kgiorgi/synthy/BOM.csv

Item | Qty | Supplier | Cost/item | Total Cost | link
LMC555CN timer (DIP-8) | 2 | LCSC | $1.69 | $3.38 | https://www.lcsc.com/product-detail/C1520185.html
CD74HC4017E counter (DIP-16) | 1 | LCSC | $0.86 | $0.86 | https://www.lcsc.com/product-detail/C354048.html
LM386N-1 amplifier (DIP-8) | 1 | LCSC | $0.90 | $0.90 | https://www.lcsc.com/product-detail/C9723.html
Slide switch SPDT (C&K OS102011MS2QN1) | 2 | LCSC | $0.66 | $1.32 | https://www.lcsc.com/product-detail/C221829.html
USB-C power socket (GCT USB4125-GF-A) | 1 | LCSC | $0.60 | $0.60 | https://www.lcsc.com/product-detail/C3151650.html
JST PH 2-pin header (min order 20) | 20 | LCSC | $0.04 | $0.80 | https://www.lcsc.com/product-detail/C131337.html
PCB 2-layer 100x100mm (5 boards) | 1 | JLCPCB | $2.00 | $2.00 | https://jlcpcb.com/quote
Resistor kit 1/4W metal film (30 values) | 1 | AliExpress | $2.00 | $2.00 | https://www.aliexpress.com/w/wholesale-metal-film-resistor-kit-1%2F4w.html
Ceramic capacitor kit (2pF to 100nF) | 1 | AliExpress | $2.00 | $2.00 | https://www.aliexpress.com/w/wholesale-ceramic-capacitor-kit.html
1uF ceramic capacitor 5mm pitch (10 pcs) | 1 | AliExpress | $0.50 | $0.50 | https://www.aliexpress.com/w/wholesale-1uf-ceramic-capacitor-105.html
47nF film capacitor CBB/MKT 473 (10 pcs) | 1 | AliExpress | $0.80 | $0.80 | https://www.aliexpress.com/w/wholesale-473-film-capacitor.html
10uF 25V electrolytic 5mm (10 pcs) | 1 | AliExpress | $0.50 | $0.50 | https://www.aliexpress.com/w/wholesale-10uf-25v-electrolytic-capacitor.html
100uF 16V electrolytic 6.3mm (10 pcs) | 1 | AliExpress | $0.60 | $0.60 | https://www.aliexpress.com/w/wholesale-100uf-16v-electrolytic-capacitor.html
220uF 16V electrolytic 8mm (10 pcs) | 1 | AliExpress | $0.70 | $0.70 | https://www.aliexpress.com/w/wholesale-220uf-16v-electrolytic-capacitor.html
3mm red LEDs (50 pcs) | 1 | AliExpress | $0.80 | $0.80 | https://www.aliexpress.com/w/wholesale-3mm-red-led.html
1N4148 diodes (100 pcs) | 1 | AliExpress | $0.80 | $0.80 | https://www.aliexpress.com/w/wholesale-1n4148-diode.html
DIP-8 IC sockets (10 pcs) | 1 | AliExpress | $0.60 | $0.60 | https://www.aliexpress.com/w/wholesale-dip8-ic-socket.html
DIP-16 IC sockets (10 pcs) | 1 | AliExpress | $0.70 | $0.70 | https://www.aliexpress.com/w/wholesale-dip16-ic-socket.html
8-way DIP switch 2.54mm (5 pcs) | 1 | AliExpress | $1.00 | $1.00 | https://www.aliexpress.com/w/wholesale-8-way-dip-switch-2.54mm.html
8 ohm 0.5W speaker 40mm (2 pcs) | 1 | AliExpress | $1.50 | $1.50 | https://www.aliexpress.com/w/wholesale-8-ohm-0.5w-speaker-40mm.html
RK097 9mm potentiometers (10x B100K 2x B50K 2x A100K) | 1 | AliExpress | $0.00 | $0.00 | https://www.aliexpress.com/w/wholesale-rk097-potentiometer.html
Estimated total shipping | 1 |  |  | $0.00
