kgiorgi/synthy/hardware/kicad/synthy/synthy.pdf

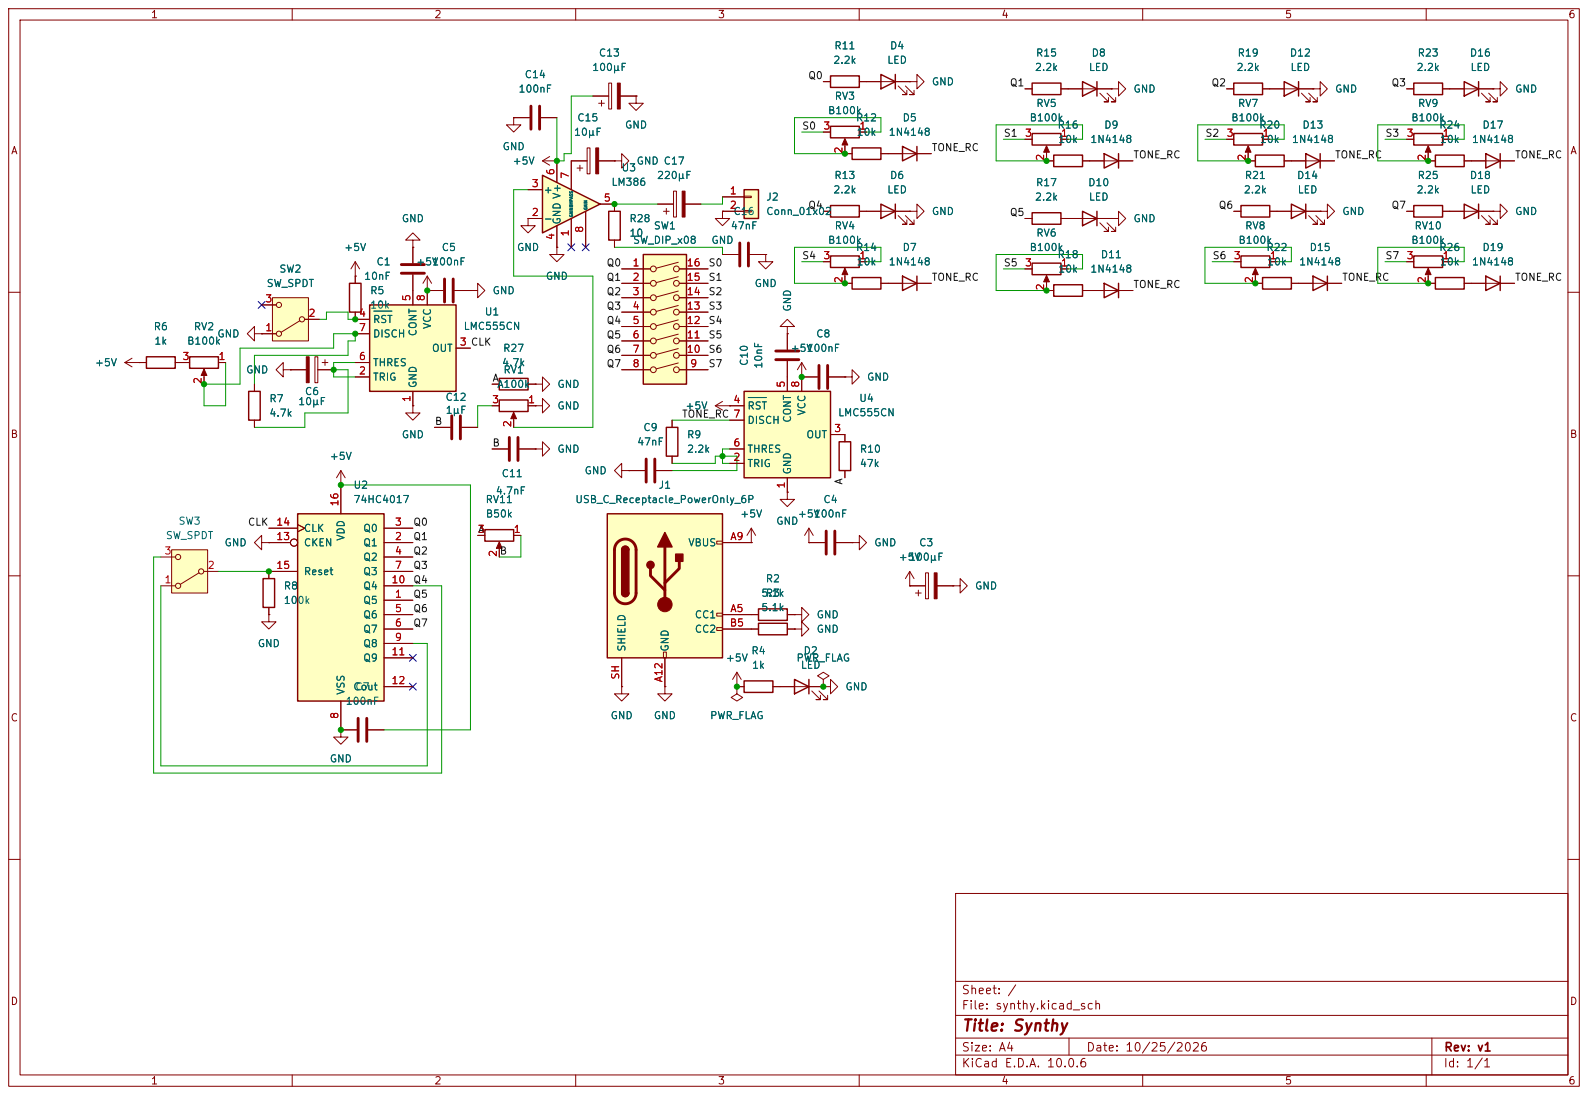
[picture p2: page 1]

8 Q8 9 Q4 10 Q9 11 Cout 12 CKEN 13 CLK 14 Reset 15 VDD 16 U2

8 Q8 9 Q4 10 Q9 11 Cout 12 CKEN 13 CLK 14 Reset 15 VDD 16 GND

Size: A4 | Rev: v1
KiCad E.D.A. 10.0.6 | Id: 1/1
