kgiorgi/synthy/hardware/kicad/synthy/synthy.kicad_pcb

## KiCad design hardware/kicad/synthy/synthy.kicad_pcb (2026-10-25)

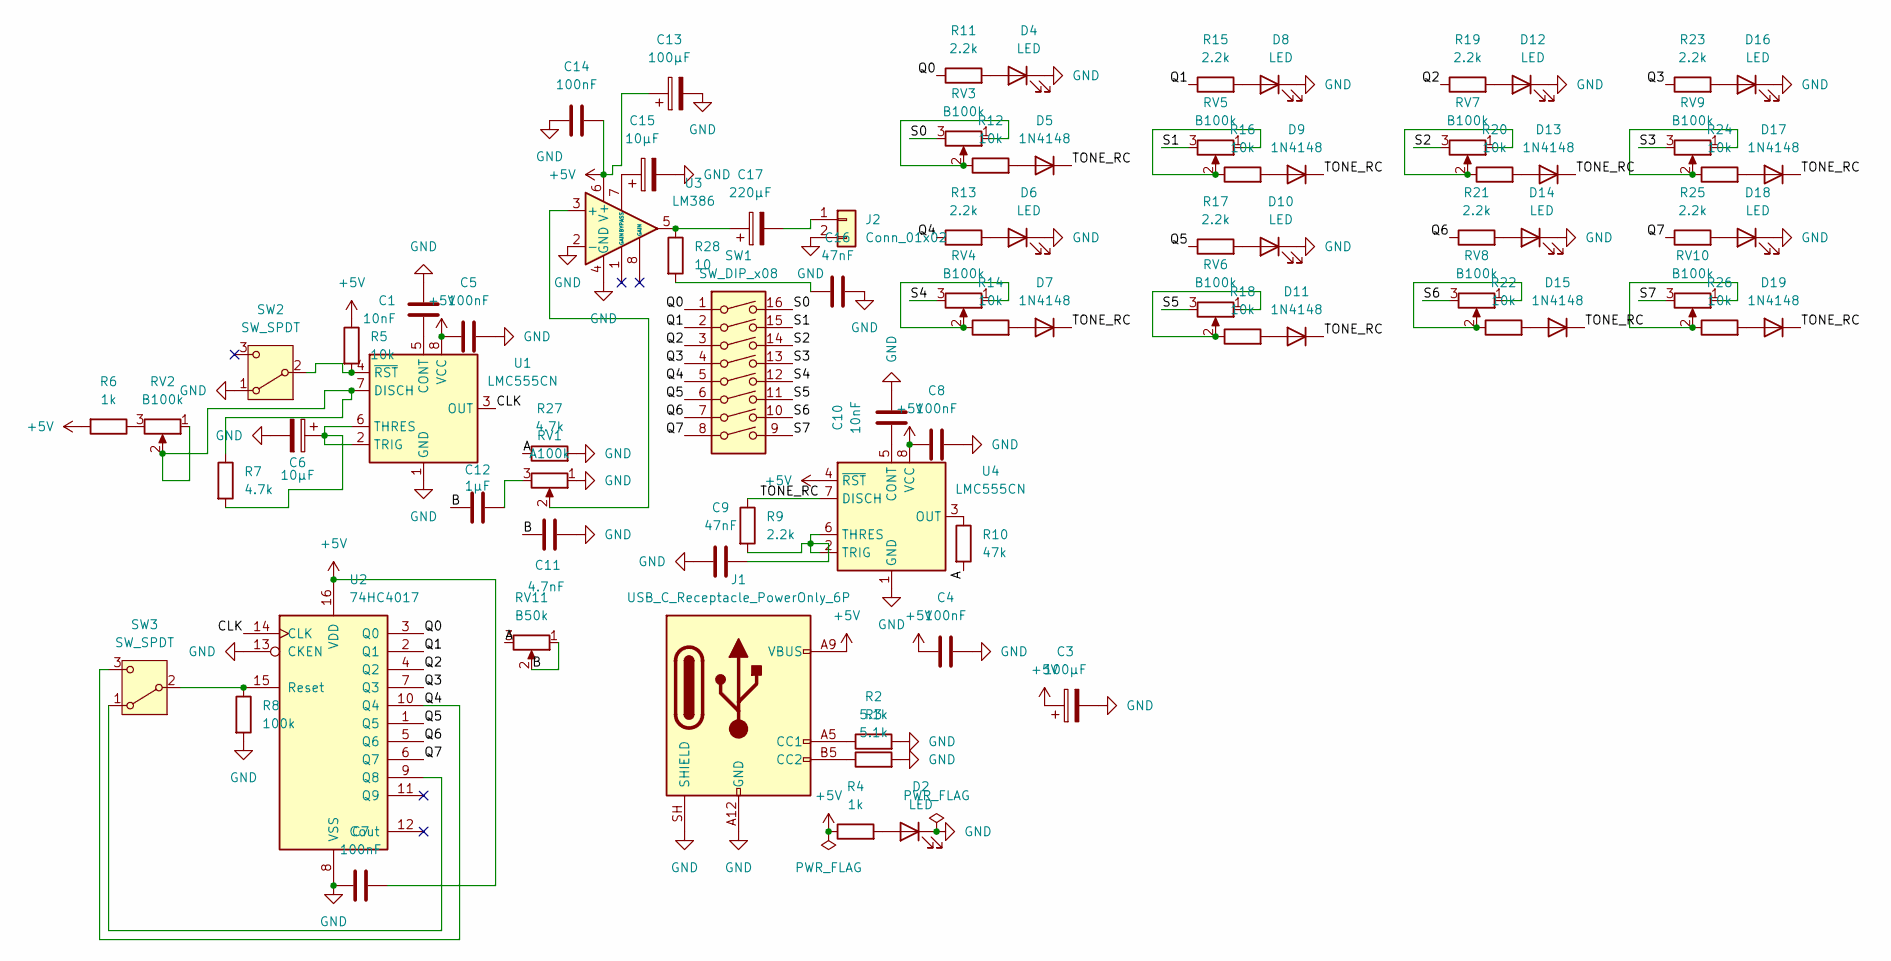
[picture p3: schematic synthy.kicad_sch]

Parts:
C1, C10: 10nF; C_Disc_D5.0mm_W2.5mm_P5.00mm
C3, C13: 100µF; CP_Radial_D6.3mm_P2.50mm
C4, C5, C7, C8, C14: 100nF; C_Disc_D5.0mm_W2.5mm_P5.00mm
C6, C15: 10µF; CP_Radial_D5.0mm_P2.00mm
C9: 47nF; C_Rect_L7.2mm_W2.5mm_P5.00mm_FKS2_FKP2_MKS2_MKP2
C11: 4.7nF; C_Disc_D5.0mm_W2.5mm_P5.00mm
C12: 1µF; C_Disc_D5.0mm_W2.5mm_P5.00mm
C16: 47nF; C_Disc_D5.0mm_W2.5mm_P5.00mm
C17: 220µF; CP_Radial_D8.0mm_P3.50mm
D2, D4, D6, D8, D10, D12, D14, D16, D18: LED; LED_D3.0mm
D5, D7, D9, D11, D13, D15, D17, D19: 1N4148; D_DO-35_SOD27_P2.54mm_Vertical_AnodeUp
J1: USB_C_Receptacle_PowerOnly_6P; USB_C_Receptacle_GCT_USB4125-xx-x-0190_6P_TopMnt_Horizontal
J2: Conn_01x02; JST_PH_B2B-PH-K_1x02_P2.00mm_Vertical
R2, R3: 5.1k; R_Axial_DIN0207_L6.3mm_D2.5mm_P10.16mm_Horizontal
R4, R6: 1k; R_Axial_DIN0207_L6.3mm_D2.5mm_P10.16mm_Horizontal
R5: 10k; R_Axial_DIN0207_L6.3mm_D2.5mm_P10.16mm_Horizontal
R7, R27: 4.7k; R_Axial_DIN0207_L6.3mm_D2.5mm_P10.16mm_Horizontal
R8: 100k; R_Axial_DIN0207_L6.3mm_D2.5mm_P10.16mm_Horizontal
R9: 2.2k; R_Axial_DIN0207_L6.3mm_D2.5mm_P10.16mm_Horizontal
R10: 47k; R_Axial_DIN0207_L6.3mm_D2.5mm_P10.16mm_Horizontal
R11, R13, R15, R17, R19, R21, R23, R25: 2.2k; R_Axial_DIN0207_L6.3mm_D2.5mm_P2.54mm_Vertical
R12, R14, R16, R18, R20, R22, R24, R26: 10k; R_Axial_DIN0207_L6.3mm_D2.5mm_P2.54mm_Vertical
R28: 10; R_Axial_DIN0207_L6.3mm_D2.5mm_P10.16mm_Horizontal
RV1: A100k; Potentiometer_Alps_RK09K_Single_Vertical
RV2, RV3, RV4, RV5, RV6, RV7, RV8, RV9, RV10: B100k; Potentiometer_Alps_RK09K_Single_Vertical
RV11: B50k; Potentiometer_Alps_RK09K_Single_Vertical
SW1: SW_DIP_x08; SW_DIP_SPSTx08_Slide_9.78x22.5mm_W7.62mm_P2.54mm
SW2, SW3: SW_SPDT; SW_Slide_SPDT_Straight_CK_OS102011MS2Q
U1, U4: LMC555CN; DIP-8_W7.62mm_Socket
U2: 74HC4017; DIP-16_W7.62mm_Socket
U3: LM386; DIP-8_W7.62mm_Socket

Connections:
+5V: C3.1, C4.1, C5.1, C7.2, C8.2, C13.1, C14.1, J1.A9 (VBUS), J1.B9 (VBUS), R4.1, R5.1, R6.2, U1.8 (VCC), U2.16 (VDD), U3.6 (V+), U4.4 (~RST), U4.8 (VCC)
/A: R10.2, R27.1, RV11.3
/B: C11.2, C12.1, RV11.1, RV11.2
/CLK: U1.3 (OUT), U2.14 (CLK)
/Q0: R11.1, SW1.1, U2.3 (Q0)
/Q1: R15.1, SW1.2, U2.2 (Q1)
/Q2: R19.1, SW1.3, U2.4 (Q2)
/Q3: R23.1, SW1.4, U2.7 (Q3)
/Q4: R13.1, SW1.5, SW3.3 (C), U2.10 (Q4)
/Q5: R17.1, SW1.6, U2.1 (Q5)
/Q6: R21.1, SW1.7, U2.5 (Q6)
/Q7: R25.1, SW1.8, U2.6 (Q7)
/S0: RV3.3, SW1.16
/S1: RV5.3, SW1.15
/S2: RV7.3, SW1.14
/S3: RV9.3, SW1.13
/S4: RV4.3, SW1.12
/S5: RV6.3, SW1.11
/S6: RV8.3, SW1.10
/S7: RV10.3, SW1.9
/TONE_RC: D5.1 (K), D7.1 (K), D9.1 (K), D11.1 (K), D13.1 (K), D15.1 (K), D17.1 (K), D19.1 (K), R9.1, U4.7 (DISCH)
GND: C1.2, C3.2, C4.2, C5.2, C6.2, C7.1, C8.1, C9.2, C10.2, C11.1, C13.2, C14.2, C15.2, C16.2, D2.1 (K), D4.1 (K), D6.1 (K), D8.1 (K), D10.1 (K), D12.1 (K), D14.1 (K), D16.1 (K), D18.1 (K), J1.A12 (GND), J1.B12 (GND), J1.SH (SHIELD), J2.2, R2.2, R3.2, R8.2, R27.2, RV1.1, SW2.1 (A), U1.1 (GND), U2.8 (VSS), U2.13 (CKEN), U3.2 (-), U3.4 (GND), U4.1 (GND)
unnamed: C12.2, RV1.3
unnamed: C16.1, R28.2
unnamed: C17.1, R28.1, U3.5
unnamed: D2.2 (A), R4.2
unnamed: D4.2 (A), R11.2
unnamed: D5.2 (A), R12.2
unnamed: D6.2 (A), R13.2
unnamed: D7.2 (A), R14.2
unnamed: D8.2 (A), R15.2
unnamed: D9.2 (A), R16.2
unnamed: D10.2 (A), R17.2
unnamed: D11.2 (A), R18.2
unnamed: D12.2 (A), R19.2
unnamed: D13.2 (A), R20.2
unnamed: D14.2 (A), R21.2
unnamed: D15.2 (A), R22.2
unnamed: D16.2 (A), R23.2
unnamed: D17.2 (A), R24.2
unnamed: D18.2 (A), R25.2
unnamed: D19.2 (A), R26.2
unnamed: J1.A5 (CC1), R2.1
unnamed: J1.B5 (CC2), R3.1
unnamed: C17.2, J2.1
unnamed: R6.1, RV2.3
unnamed: R12.1, RV3.1, RV3.2
unnamed: R14.1, RV4.1, RV4.2
unnamed: R16.1, RV5.1, RV5.2
unnamed: R18.1, RV6.1, RV6.2
unnamed: R20.1, RV7.1, RV7.2
unnamed: R22.1, RV8.1, RV8.2
unnamed: R24.1, RV9.1, RV9.2
unnamed: R26.1, RV10.1, RV10.2
unnamed: R5.2, SW2.2 (B), U1.4 (~RST)
unnamed: SW3.1 (A), U2.9 (Q8)
unnamed: R8.1, SW3.2 (B), U2.15 (Reset)
unnamed: C1.1, U1.5 (CONT)
unnamed: R7.1, RV2.1, RV2.2, U1.7 (DISCH)
unnamed: C6.1, R7.2, U1.2 (TRIG), U1.6 (THRES)
unnamed: RV1.2, U3.3 (+)
unnamed: C15.1, U3.7 (BYPASS)
unnamed: C10.1, U4.5 (CONT)
unnamed: R10.1, U4.3 (OUT)
unnamed: C9.1, R9.2, U4.2 (TRIG), U4.6 (THRES)

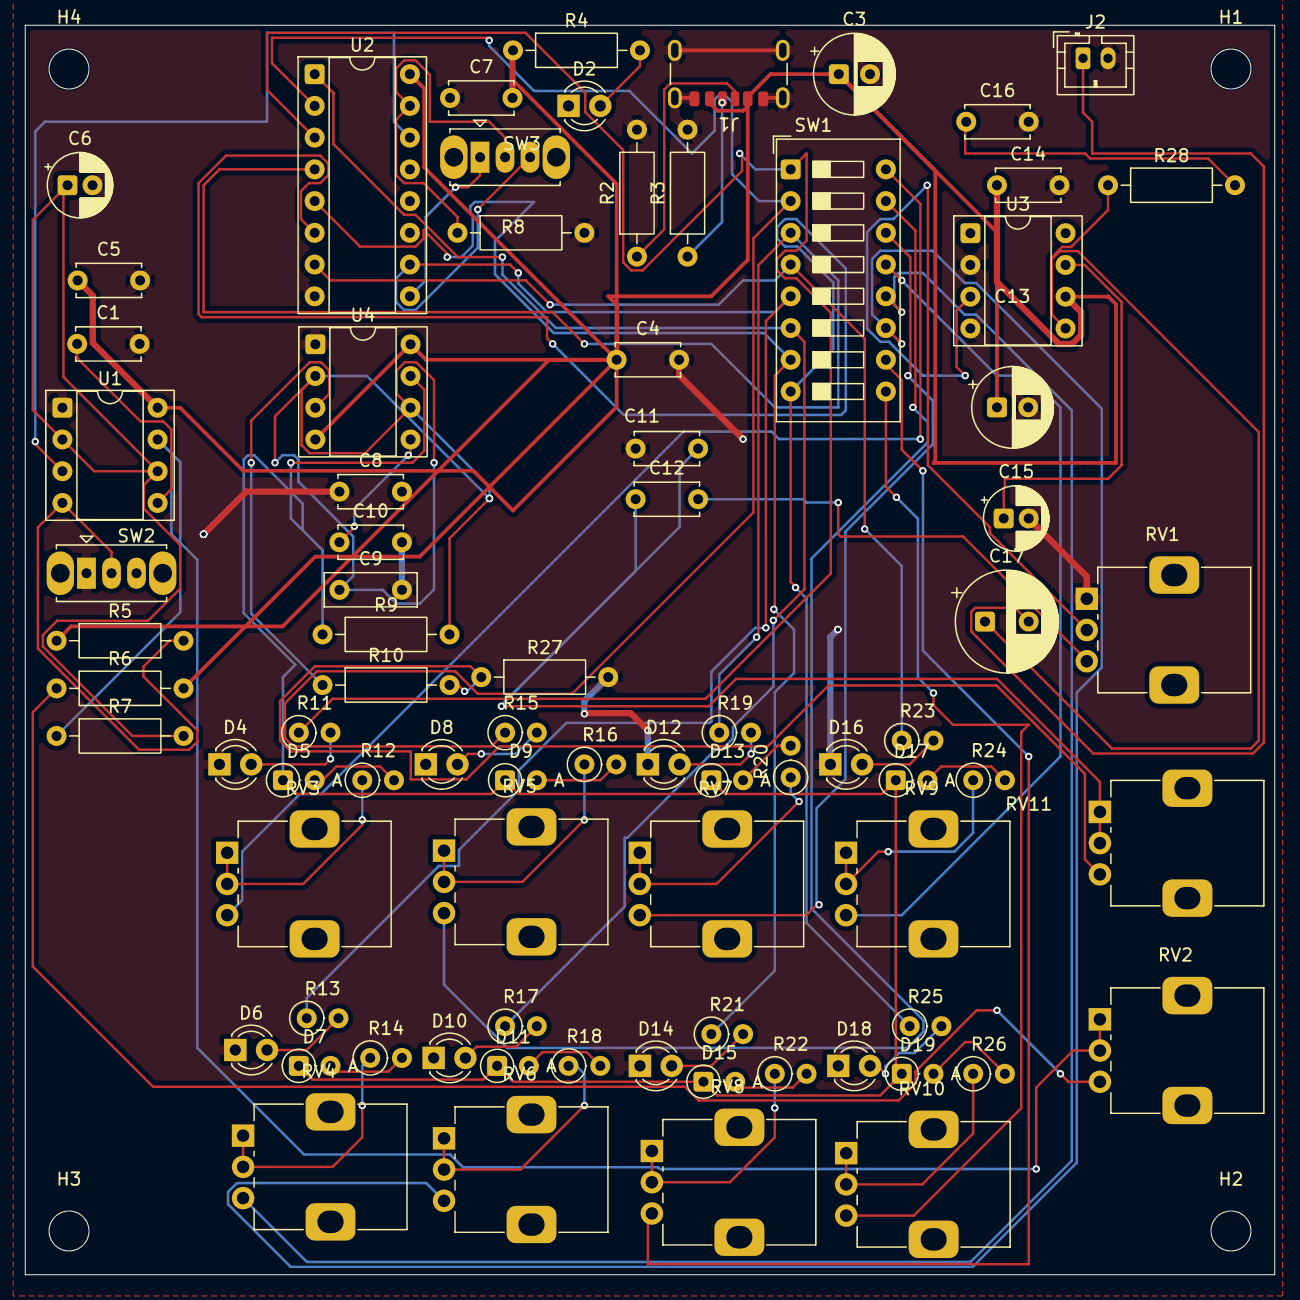
[picture p4: board synthy.kicad_pcb from above]

Board: 2 copper layers, 100.0 x 100.0 mm, 84 parts (0 on the bottom side), 65 nets.

Other parts of the board:
H1, H2, H3, H4: MountingHole_3.2mm_M3
