kgiorgi/synthy/JOURNAL.md

# synthy – devlog

<!-- Generated by Half Life from project cmveqqpzx09vb01rc97nfprkl. Edits here are overwritten on the next sync. -->
<!-- Generated: 2026-10-25T23:50:43.957Z -->

> [!NOTE]
> This devlog is mirrored from [Half Life](https://halflife.hackclub.com) – [open the project](https://halflife.hackclub.com/projects/cmveqqpzx09vb01rc97nfprkl). Editing it here will not change the platform's copy, and the next sync overwrites this file.

> Sytnhy is a small 8-strp sequencer synth with no microcontroller or firmware. A 555 timer acts as a clock and 4017 counter steps through 8 knobs, one at a time. Each knob sets the pitch of the note so the board plays looping melody that you shape by turning them

| Week | Tier | Hours logged | Entries |
| --- | --- | --- | --- |
| Week 3 | Tier 1 | 12h | 2 |

## Contents

1. [2026-10-24 – ](#2026-10-24-screenshot-2026-10-24-194841httpshalflifehackclub)
2. [2026-10-25 – ](#2026-10-25-screenshot-2026-10-25-172530httpshalflifehackclub)

## Design

### 2026-10-24 – 

**2h**





checked the numbers everything added up. Originally I was kinda slow and wanted to calculate the frequencies by hand but eventually I figured out how to set the graph up and where to look at which took well a while.

### 2026-10-25 – 

**10h**





















It took a lot of courage to finish this project. I had to learn another new tool and adapt entirely new part of the tool I got to now only a few weeks ago and this time it was merciless. Routing this many components was like untying a not(pun intended) and well I did badly mainly because well time was ticking. Schematic was relaxing though
