kgiorgi/synthy/(commit log)

2026-10-24 repo set up
    [synthy.kicad_pcb, synthy.kicad_sch]
2026-10-24 Simulate both timers
2026-10-25 finished schematic+ routing
    [synthy.kicad_pcb, synthy.kicad_sch]
2026-10-26 Sync synthy from Half Life
    [BOM.csv]
